mmaisonneuve3/Senior_Design/EEG_cap_final.brd

## EAGLE design EEG_cap_final.brd (2021-11-14)

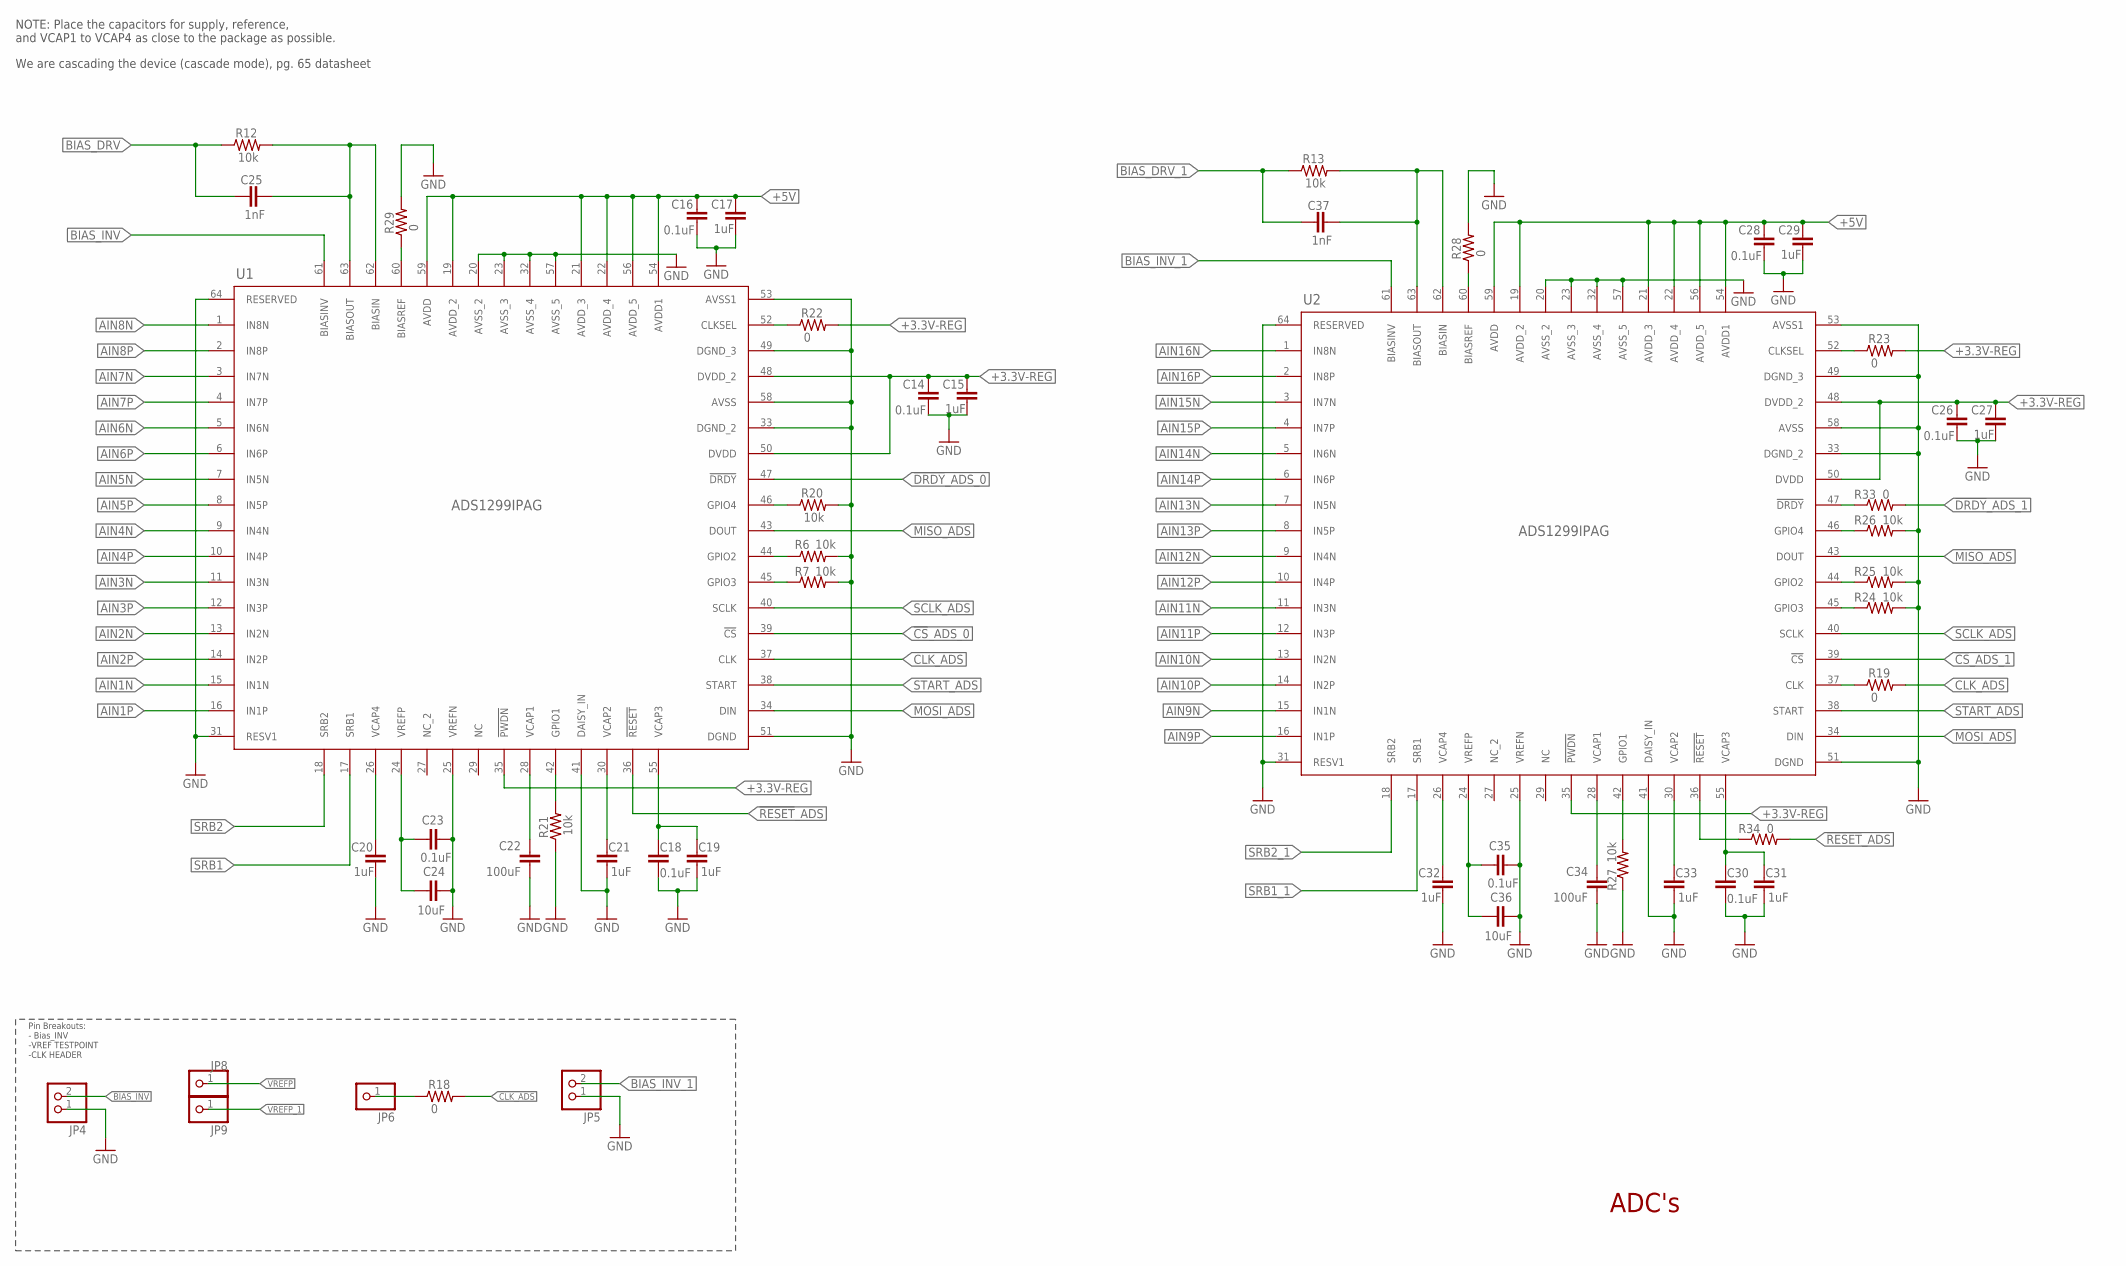
[picture p1: schematic EEG_cap_final.sch, sheet 1]

Parts:
C14, C16, C18, C23, C26, C28, C30, C35: 0.1uF; C0603
C15, C17, C19, C20, C21, C27, C29, C31, C32, C33: 1uF; C0603
C22, C34: 100uF; C1210
C24, C36: 10uF; C0805
C25, C37: 1nF; C0603
JP4, JP5: PINHD-1X2; 1X02
JP6, JP8, JP9: PINHD-1X1; 1X01
R6, R7, R12, R13, R20, R21, R24, R25, R26, R27: 10k; R0805
R18, R19, R22, R23, R28, R29, R33, R34: 0; R0805
U1, U2: ADS1299IPAG; PAG64_TEX

Connections:
!CS!_ADS_0: U1.39 (!CS); also elsewhere on the board
!CS!_ADS_1: U2.39 (!CS); also elsewhere on the board
!DRDY!_1: R33.1, U2.47 (!DRDY)
!DRDY!_ADS_0: U1.47 (!DRDY); also elsewhere on the board
!DRDY!_ADS_1: R33.2; also elsewhere on the board
!RESET!_ADS: R34.2, U1.36 (!RESET); also elsewhere on the board
!RESET!_ADS_1: R34.1, U2.36 (!RESET)
+3.3V-REG: C14.1, C15.1, C26.1, C27.1, R22.2, R23.2, U1.35 (!PWDN), U1.48 (DVDD_2), U1.50 (DVDD), U2.35 (!PWDN), U2.48 (DVDD_2), U2.50 (DVDD); also elsewhere on the board
+5V: C16.1, C17.1, C28.1, C29.1, U1.19 (AVDD_2), U1.21 (AVDD_3), U1.22 (AVDD_4), U1.54 (AVDD1), U1.56 (AVDD_5), U1.59 (AVDD), U2.19 (AVDD_2), U2.21 (AVDD_3), U2.22 (AVDD_4), U2.54 (AVDD1), U2.56 (AVDD_5), U2.59 (AVDD); also elsewhere on the board
AIN1N: U1.15 (IN1N); also elsewhere on the board
AIN1P: U1.16 (IN1P); also elsewhere on the board
AIN2N: U1.13 (IN2N); also elsewhere on the board
AIN2P: U1.14 (IN2P); also elsewhere on the board
AIN3N: U1.11 (IN3N); also elsewhere on the board
AIN3P: U1.12 (IN3P); also elsewhere on the board
AIN4N: U1.9 (IN4N); also elsewhere on the board
AIN4P: U1.10 (IN4P); also elsewhere on the board
AIN5N: U1.7 (IN5N); also elsewhere on the board
AIN5P: U1.8 (IN5P); also elsewhere on the board
AIN6N: U1.5 (IN6N); also elsewhere on the board
AIN6P: U1.6 (IN6P); also elsewhere on the board
AIN7N: U1.3 (IN7N); also elsewhere on the board
AIN7P: U1.4 (IN7P); also elsewhere on the board
AIN8N: U1.1 (IN8N); also elsewhere on the board
AIN8P: U1.2 (IN8P); also elsewhere on the board
AIN9N: U2.15 (IN1N); also elsewhere on the board
AIN9P: U2.16 (IN1P); also elsewhere on the board
AIN10N: U2.13 (IN2N); also elsewhere on the board
AIN10P: U2.14 (IN2P); also elsewhere on the board
AIN11N: U2.11 (IN3N); also elsewhere on the board
AIN11P: U2.12 (IN3P); also elsewhere on the board
AIN12N: U2.9 (IN4N); also elsewhere on the board
AIN12P: U2.10 (IN4P); also elsewhere on the board
AIN13N: U2.7 (IN5N); also elsewhere on the board
AIN13P: U2.8 (IN5P); also elsewhere on the board
AIN14N: U2.5 (IN6N); also elsewhere on the board
AIN14P: U2.6 (IN6P); also elsewhere on the board
AIN15N: U2.3 (IN7N); also elsewhere on the board
AIN15P: U2.4 (IN7P); also elsewhere on the board
AIN16N: U2.1 (IN8N); also elsewhere on the board
AIN16P: U2.2 (IN8P); also elsewhere on the board
BIAS1_IN: C37.2, R13.2, U2.62 (BIASIN), U2.63 (BIASOUT)
BIAS_DRV: C25.1, R12.1; also elsewhere on the board
BIAS_DRV_1: C37.1, R13.1; also elsewhere on the board
BIAS_IN: C25.2, R12.2, U1.62 (BIASIN), U1.63 (BIASOUT)
BIAS_INV: JP4.2, U1.61 (BIASINV)
BIAS_INV_1: JP5.2, U2.61 (BIASINV)
BIAS_REF: R29.1, U1.60 (BIASREF)
BIAS_REF_1: R28.1, U2.60 (BIASREF)
CLK: R19.1, U2.37 (CLK)
CLKSEL_0: R22.1, U1.52 (CLKSEL)
CLKSEL_1: R23.1, U2.52 (CLKSEL)
CLK_ADS: R18.2, R19.2, U1.37 (CLK)
CLK_HDR: JP6.1, R18.1
GND: C14.2, C15.2, C16.2, C17.2, C18.2, C19.2, C20.2, C21.2, C22.2, C23.2, C24.2, C26.2, C27.2, C28.2, C29.2, C30.2, C31.2, C32.2, C33.2, C34.2, C35.2, C36.2, JP4.1, JP5.1, R6.2, R7.2, R20.2, R21.1, R24.2, R25.2, R26.2, R27.1, R28.2, R29.2, U1.20 (AVSS_2), U1.23 (AVSS_3), U1.25 (VREFN), U1.31 (RESV1), U1.32 (AVSS_4), U1.33 (DGND_2), U1.41 (DAISY_IN), U1.49 (DGND_3), U1.51 (DGND), U1.53 (AVSS1), U1.57 (AVSS_5), U1.58 (AVSS), U1.64 (RESERVED), U2.20 (AVSS_2), U2.23 (AVSS_3), U2.25 (VREFN), U2.31 (RESV1), U2.32 (AVSS_4), U2.33 (DGND_2), U2.41 (DAISY_IN), U2.49 (DGND_3), U2.51 (DGND), U2.53 (AVSS1), U2.57 (AVSS_5), U2.58 (AVSS), U2.64 (RESERVED); also elsewhere on the board
MISO_ADS: U1.43 (DOUT), U2.43 (DOUT); also elsewhere on the board
MOSI_ADS: U1.34 (DIN), U2.34 (DIN); also elsewhere on the board
unnamed: R21.2, U1.42 (GPIO1)
unnamed: R7.1, U1.45 (GPIO3)
unnamed: R6.1, U1.44 (GPIO2)
unnamed: R20.1, U1.46 (GPIO4)
unnamed: R24.1, U2.45 (GPIO3)
unnamed: R25.1, U2.44 (GPIO2)
unnamed: R26.1, U2.46 (GPIO4)
unnamed: R27.2, U2.42 (GPIO1)
SCLK_ADS: U1.40 (SCLK), U2.40 (SCLK); also elsewhere on the board
SRB1: U1.17 (SRB1); also elsewhere on the board
SRB1_1: U2.17 (SRB1); also elsewhere on the board
SRB2: U1.18 (SRB2); also elsewhere on the board
SRB2_1: U2.18 (SRB2); also elsewhere on the board
START_ADS: U1.38 (START), U2.38 (START); also elsewhere on the board
VCAP1: C22.1, U1.28 (VCAP1)
VCAP1_1: C34.1, U2.28 (VCAP1)
VCAP2: C21.1, U1.30 (VCAP2)
VCAP2_1: C33.1, U2.30 (VCAP2)
VCAP3: C18.1, C19.1, U1.55 (VCAP3)
VCAP3_1: C30.1, C31.1, U2.55 (VCAP3)
VCAP4: C20.1, U1.26 (VCAP4)
VCAP6: C32.1, U2.26 (VCAP4)
VREFP: C23.1, C24.1, JP8.1, U1.24 (VREFP)
VREFP_1: C35.1, C36.1, JP9.1, U2.24 (VREFP)

Notes on the sheet:
ADC's
NOTE: Place the capacitors for supply, reference, and VCAP1 to VCAP4 as close to the package as possible.
We are cascading the device (cascade mode), pg. 65 datasheet
Pin Breakouts: - Bias_INV -VREF TESTPOINT -CLK HEADER

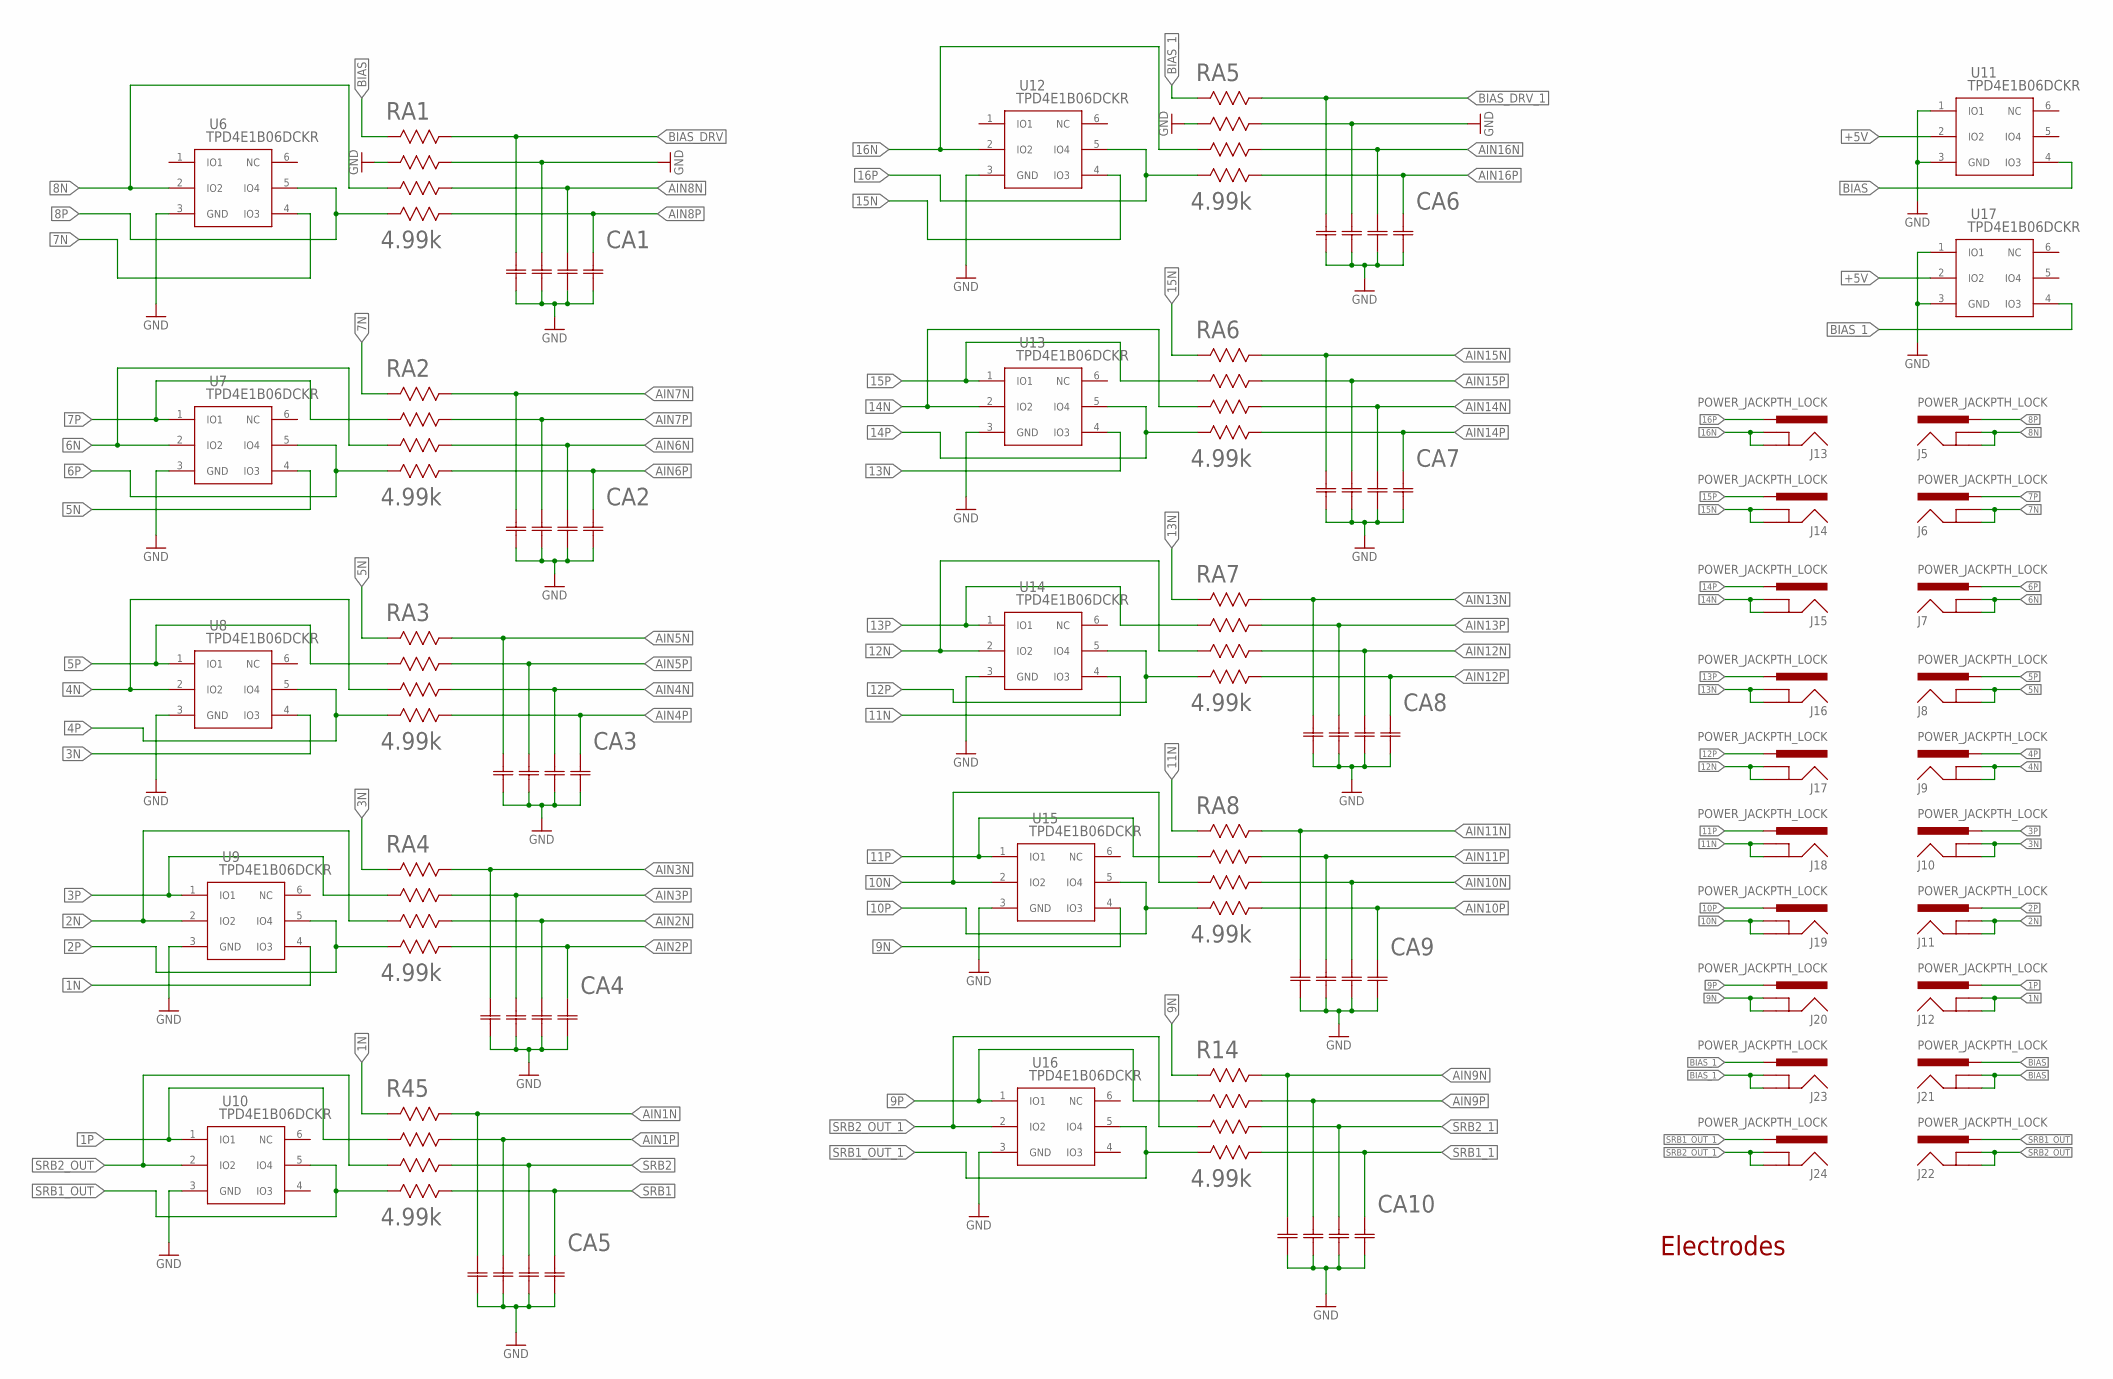
[picture p2: schematic EEG_cap_final.sch, sheet 2]

Parts:
CA1, CA2, CA3, CA4, CA5, CA6, CA7, CA8, CA9, CA10: 4.7nF; CAP_CA0612_3P2X1P6_YAG
J5, J6, J7, J8, J9, J10, J11, J12, J13, J14, J15, J16, J17, J18, J19, J20, J21, J22, J23, J24: POWER_JACKPTH_LOCK; POWER_JACK_PTH_LOCK
R14, R45: 4.99k; BO_CAT16
RA1, RA2, RA3, RA4, RA5, RA6, RA7, RA8: 4.99k; BO_CAT16
U6, U7, U8, U9, U10, U11, U12, U13, U14, U15, U16, U17: TPD4E1B06DCKR; DCK6_TEX

Connections:
1N: J12.GND, J12.GNDBREAK, R45.1, U9.4 (IO3)
1P: J12.PWR, R45.2, U10.1 (IO1)
2N: J11.GND, J11.GNDBREAK, RA4.3, U9.2 (IO2)
2P: J11.PWR, RA4.4, U9.5 (IO4)
3N: J10.GND, J10.GNDBREAK, RA4.1, U8.4 (IO3)
3P: J10.PWR, RA4.2, U9.1 (IO1)
4N: J9.GND, J9.GNDBREAK, RA3.3, U8.2 (IO2)
4P: J9.PWR, RA3.4, U8.5 (IO4)
5N: J8.GND, J8.GNDBREAK, RA3.1, U7.4 (IO3)
5P: J8.PWR, RA3.2, U8.1 (IO1)
6N: J7.GND, J7.GNDBREAK, RA2.3, U7.2 (IO2)
6P: J7.PWR, RA2.4, U7.5 (IO4)
7N: J6.GND, J6.GNDBREAK, RA2.1, U6.4 (IO3)
7P: J6.PWR, RA2.2, U7.1 (IO1)
8N: J5.GND, J5.GNDBREAK, RA1.3, U6.2 (IO2)
8P: J5.PWR, RA1.4, U6.5 (IO4)
9N: J20.GND, J20.GNDBREAK, R14.1, U15.4 (IO3)
9P: J20.PWR, R14.2, U16.1 (IO1)
10N: J19.GND, J19.GNDBREAK, RA8.3, U15.2 (IO2)
10P: J19.PWR, RA8.4, U15.5 (IO4)
11N: J18.GND, J18.GNDBREAK, RA8.1, U14.4 (IO3)
11P: J18.PWR, RA8.2, U15.1 (IO1)
12N: J17.GND, J17.GNDBREAK, RA7.3, U14.2 (IO2)
12P: J17.PWR, RA7.4, U14.5 (IO4)
13N: J16.GND, J16.GNDBREAK, RA7.1, U13.4 (IO3)
13P: J16.PWR, RA7.2, U14.1 (IO1)
14N: J15.GND, J15.GNDBREAK, RA6.3, U13.2 (IO2)
14P: J15.PWR, RA6.4, U13.5 (IO4)
15N: J14.GND, J14.GNDBREAK, RA6.1, U12.4 (IO3)
15P: J14.PWR, RA6.2, U13.1 (IO1)
16N: J13.GND, J13.GNDBREAK, RA5.3, U12.2 (IO2)
16P: J13.PWR, RA5.4, U12.5 (IO4)
+5V: U11.2 (IO2), U17.2 (IO2); also elsewhere on the board
AIN1N: CA5.8, R45.8; also elsewhere on the board
AIN1P: CA5.7, R45.7; also elsewhere on the board
AIN2N: CA4.6, RA4.6; also elsewhere on the board
AIN2P: CA4.5, RA4.5; also elsewhere on the board
AIN3N: CA4.8, RA4.8; also elsewhere on the board
AIN3P: CA4.7, RA4.7; also elsewhere on the board
AIN4N: CA3.6, RA3.6; also elsewhere on the board
AIN4P: CA3.5, RA3.5; also elsewhere on the board
AIN5N: CA3.8, RA3.8; also elsewhere on the board
AIN5P: CA3.7, RA3.7; also elsewhere on the board
AIN6N: CA2.6, RA2.6; also elsewhere on the board
AIN6P: CA2.5, RA2.5; also elsewhere on the board
AIN7N: CA2.8, RA2.8; also elsewhere on the board
AIN7P: CA2.7, RA2.7; also elsewhere on the board
AIN8N: CA1.6, RA1.6; also elsewhere on the board
AIN8P: CA1.5, RA1.5; also elsewhere on the board
AIN9N: CA10.8, R14.8; also elsewhere on the board
AIN9P: CA10.7, R14.7; also elsewhere on the board
AIN10N: CA9.6, RA8.6; also elsewhere on the board
AIN10P: CA9.5, RA8.5; also elsewhere on the board
AIN11N: CA9.8, RA8.8; also elsewhere on the board
AIN11P: CA9.7, RA8.7; also elsewhere on the board
AIN12N: CA8.6, RA7.6; also elsewhere on the board
AIN12P: CA8.5, RA7.5; also elsewhere on the board
AIN13N: CA8.8, RA7.8; also elsewhere on the board
AIN13P: CA8.7, RA7.7; also elsewhere on the board
AIN14N: CA7.6, RA6.6; also elsewhere on the board
AIN14P: CA7.5, RA6.5; also elsewhere on the board
AIN15N: CA7.8, RA6.8; also elsewhere on the board
AIN15P: CA7.7, RA6.7; also elsewhere on the board
AIN16N: CA6.6, RA5.6; also elsewhere on the board
AIN16P: CA6.5, RA5.5; also elsewhere on the board
BIAS: J21.GND, J21.GNDBREAK, J21.PWR, RA1.1, U11.4 (IO3)
BIAS_1: J23.GND, J23.GNDBREAK, J23.PWR, RA5.1, U17.4 (IO3)
BIAS_DRV: CA1.8, RA1.8; also elsewhere on the board
BIAS_DRV_1: CA6.8, RA5.8; also elsewhere on the board
GND: CA1.1, CA1.2, CA1.3, CA1.4, CA1.7, CA2.1, CA2.2, CA2.3, CA2.4, CA3.1, CA3.2, CA3.3, CA3.4, CA4.1, CA4.2, CA4.3, CA4.4, CA5.1, CA5.2, CA5.3, CA5.4, CA6.1, CA6.2, CA6.3, CA6.4, CA6.7, CA7.1, CA7.2, CA7.3, CA7.4, CA8.1, CA8.2, CA8.3, CA8.4, CA9.1, CA9.2, CA9.3, CA9.4, CA10.1, CA10.2, CA10.3, CA10.4, RA1.2, RA1.7, RA5.2, RA5.7, U6.3 (GND), U7.3 (GND), U8.3 (GND), U9.3 (GND), U10.3 (GND), U11.1 (IO1), U11.3 (GND), U12.3 (GND), U13.3 (GND), U14.3 (GND), U15.3 (GND), U16.3 (GND), U17.1 (IO1), U17.3 (GND); also elsewhere on the board
SRB1: CA5.5, R45.5; also elsewhere on the board
SRB1_1: CA10.5, R14.5; also elsewhere on the board
SRB1_OUT: J22.PWR, R45.4, U10.5 (IO4)
SRB1_OUT_1: J24.PWR, R14.4, U16.5 (IO4)
SRB2: CA5.6, R45.6; also elsewhere on the board
SRB2_1: CA10.6, R14.6; also elsewhere on the board
SRB2_OUT: J22.GND, J22.GNDBREAK, R45.3, U10.2 (IO2)
SRB2_OUT_1: J24.GND, J24.GNDBREAK, R14.3, U16.2 (IO2)

Notes on the sheet:
Electrodes

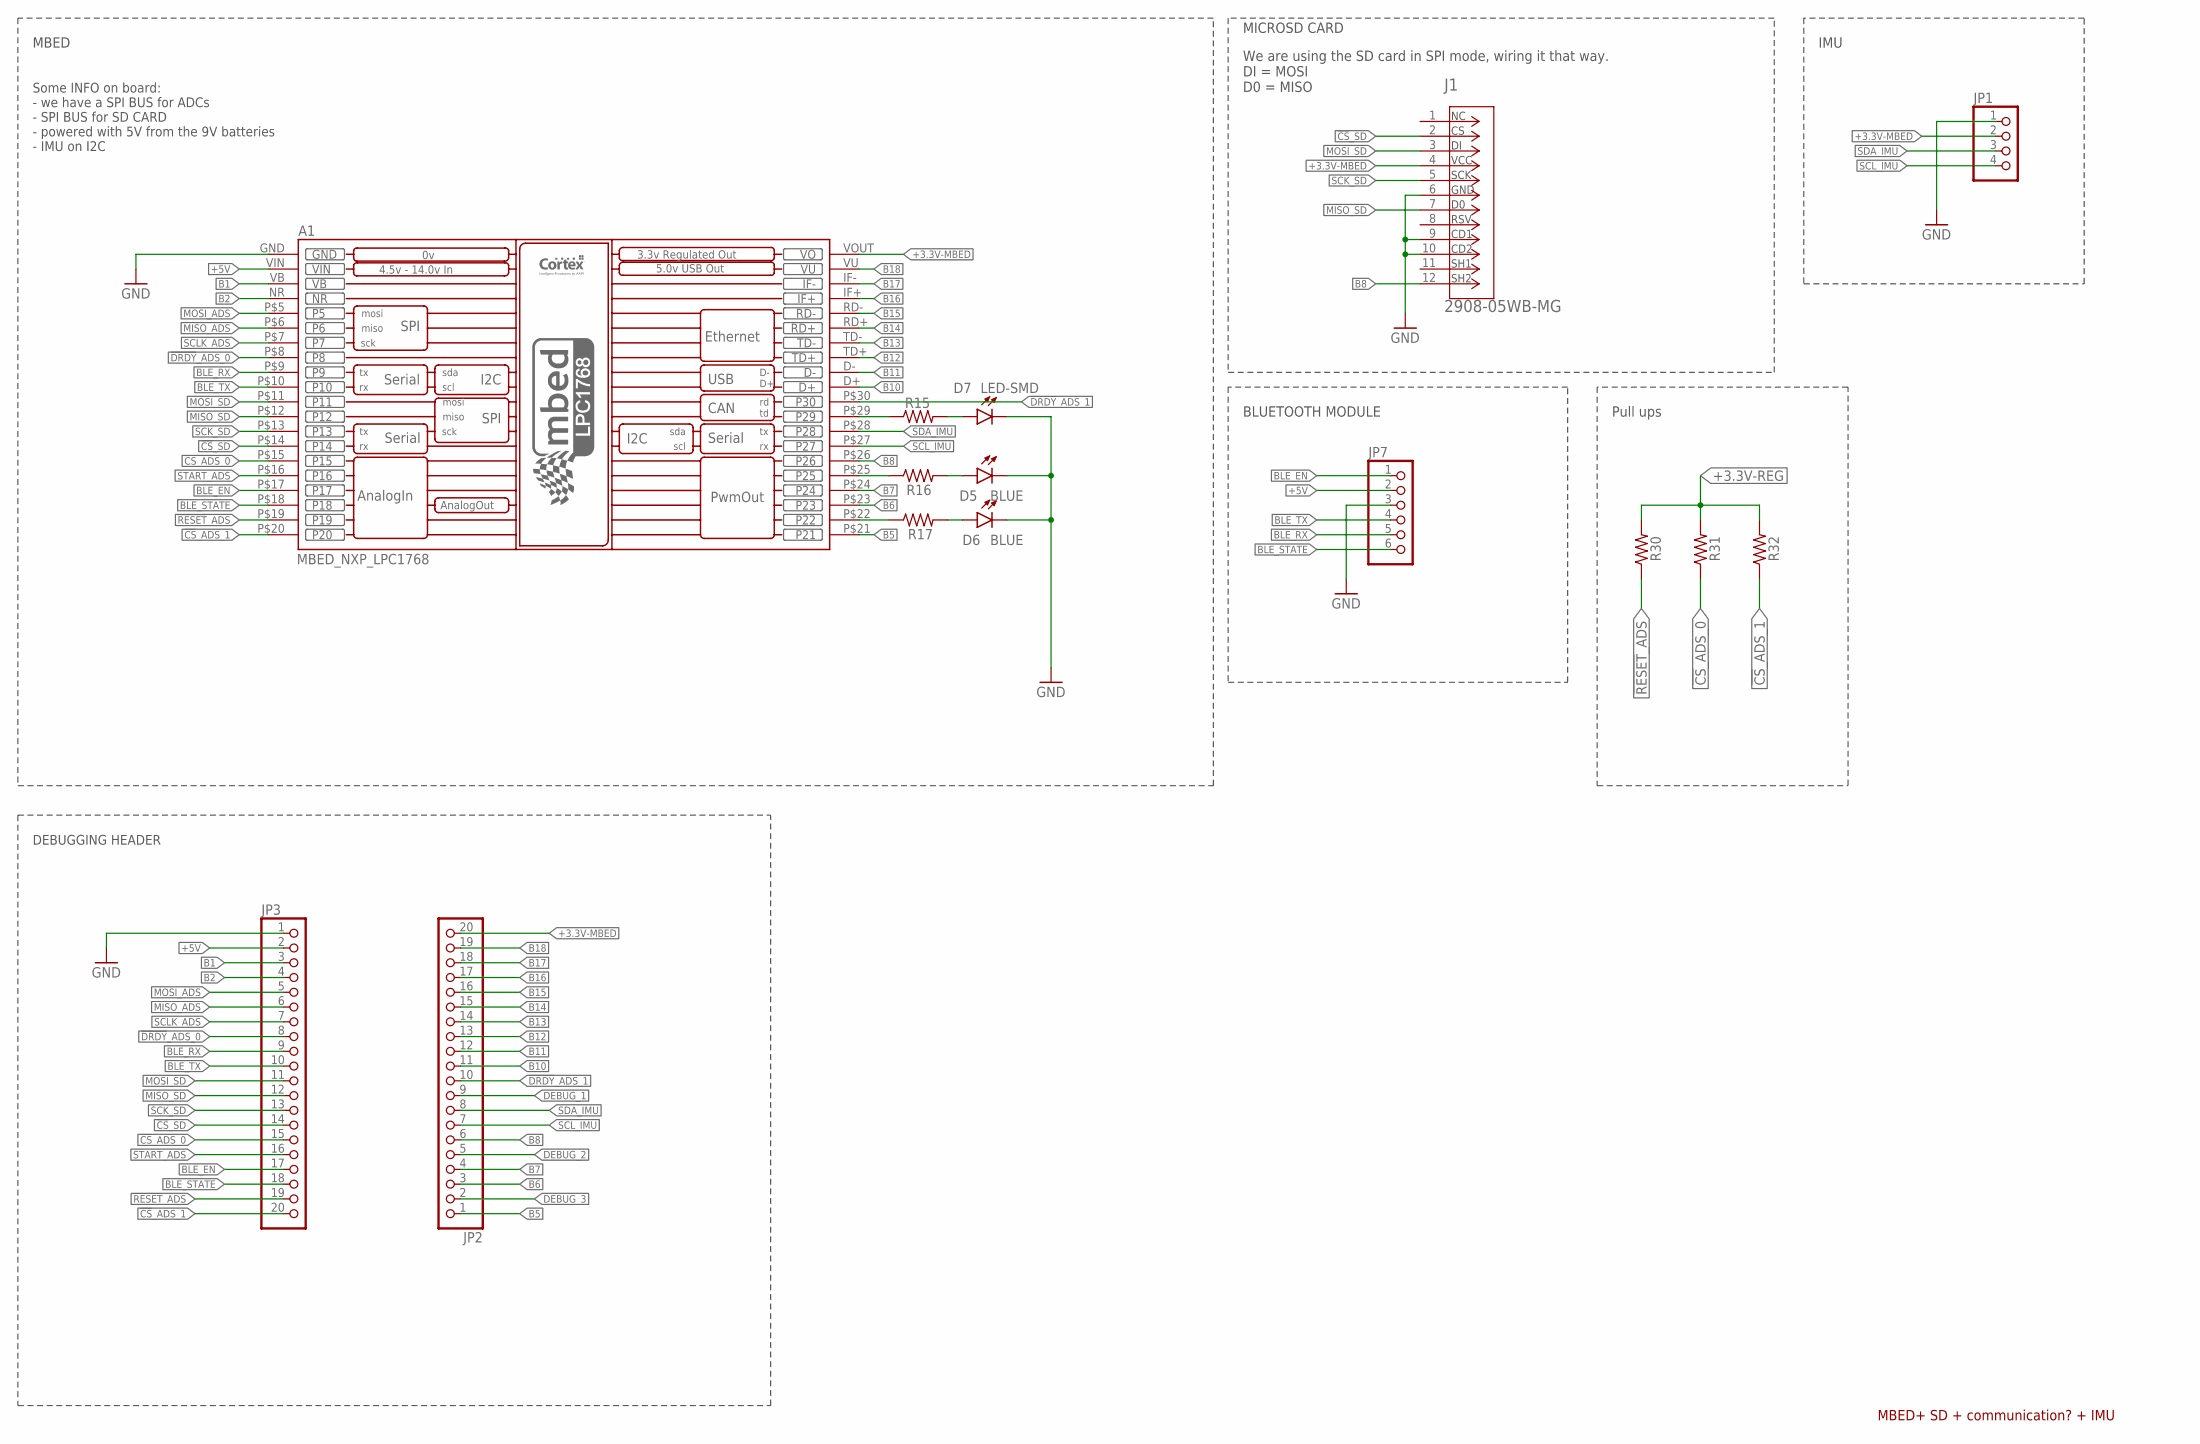
[picture p3: schematic EEG_cap_final.sch, sheet 3]

Parts:
A1: MBED_NXP_LPC1768; MBED_LPC1768
D5, D6: BLUE; LED0603
D7: LED-SMD; LED0603
J1: 2908-05WB-MG; CONN_3M_2900
JP1: PINHD-1X4; 1X04
JP2, JP3: PINHD-1X20; 1X20
JP7: PINHD-1X6; 1X06
R15, R16, R17, R31, R32: 1k; R0805
R30: 10k; R0805

Connections:
!CS!_ADS_0: A1.P$15 (P15), JP3.15, R31.1; also elsewhere on the board
!CS!_ADS_1: A1.P$20 (P20), JP3.20, R32.1; also elsewhere on the board
!CS!_SD: A1.P$14 (P14), J1.2, JP3.14
!DRDY!_ADS_0: A1.P$8 (P8), JP3.8; also elsewhere on the board
!DRDY!_ADS_1: A1.P$30 (P30), JP2.10; also elsewhere on the board
!RESET!_ADS: A1.P$19 (P19), JP3.19, R30.1; also elsewhere on the board
+3.3V-MBED: A1.VOUT (VO), J1.4, JP1.2, JP2.20; also elsewhere on the board
+3.3V-REG: R30.2, R31.2, R32.2; also elsewhere on the board
+5V: A1.VIN, JP3.2, JP7.2; also elsewhere on the board
B1: A1.VB, JP3.3
B2: A1.NR, JP3.4
B5: A1.P$21 (P21), JP2.1
B6: A1.P$23 (P23), JP2.3
B7: A1.P$24 (P24), JP2.4
B8: A1.P$26 (P26), J1.12, JP2.6
B10: A1.D+, JP2.11
B11: A1.D-, JP2.12
B12: A1.TD+, JP2.13
B13: A1.TD-, JP2.14
B14: A1.RD+, JP2.15
B15: A1.RD-, JP2.16
B16: A1.IF+, JP2.17
B17: A1.IF-, JP2.18
B18: A1.VU, JP2.19
BLE_EN: A1.P$17 (P17), JP3.17, JP7.1
BLE_RX: A1.P$9 (P9), JP3.9, JP7.5
BLE_STATE: A1.P$18 (P18), JP3.18, JP7.6
BLE_TX: A1.P$10 (P10), JP3.10, JP7.4
DEBUG_1: A1.P$29 (P29), JP2.9, R15.1
DEBUG_2: A1.P$25 (P25), JP2.5, R16.1
DEBUG_3: A1.P$22 (P22), JP2.2, R17.1
GND: A1.GND, D5.C, D6.C, D7.C, J1.6, J1.9, J1.10, JP1.1, JP3.1, JP7.3; also elsewhere on the board
LED-1: D7.A, R15.2
LED_2: D5.A, R16.2
LED_3: D6.A, R17.2
MISO_ADS: A1.P$6 (P6), JP3.6; also elsewhere on the board
MISO_SD: A1.P$12 (P12), J1.7, JP3.12
MOSI_ADS: A1.P$5 (P5), JP3.5; also elsewhere on the board
MOSI_SD: A1.P$11 (P11), J1.3, JP3.11
SCK_SD: A1.P$13 (P13), J1.5, JP3.13
SCLK_ADS: A1.P$7 (P7), JP3.7; also elsewhere on the board
SCL_IMU: A1.P$27 (P27), JP1.4, JP2.7
SDA_IMU: A1.P$28 (P28), JP1.3, JP2.8
START_ADS: A1.P$16 (P16), JP3.16; also elsewhere on the board

Notes on the sheet:
MBED+ SD + communication? + IMU
MBED
MICROSD CARD
We are using the SD card in SPI mode, wiring it that way. DI = MOSI D0 = MISO
Some INFO on board: - we have a SPI BUS for ADCs - SPI BUS for SD CARD - powered with 5V from the 9V batteries - IMU on I2C
IMU
DEBUGGING HEADER
BLUETOOTH MODULE
Pull ups

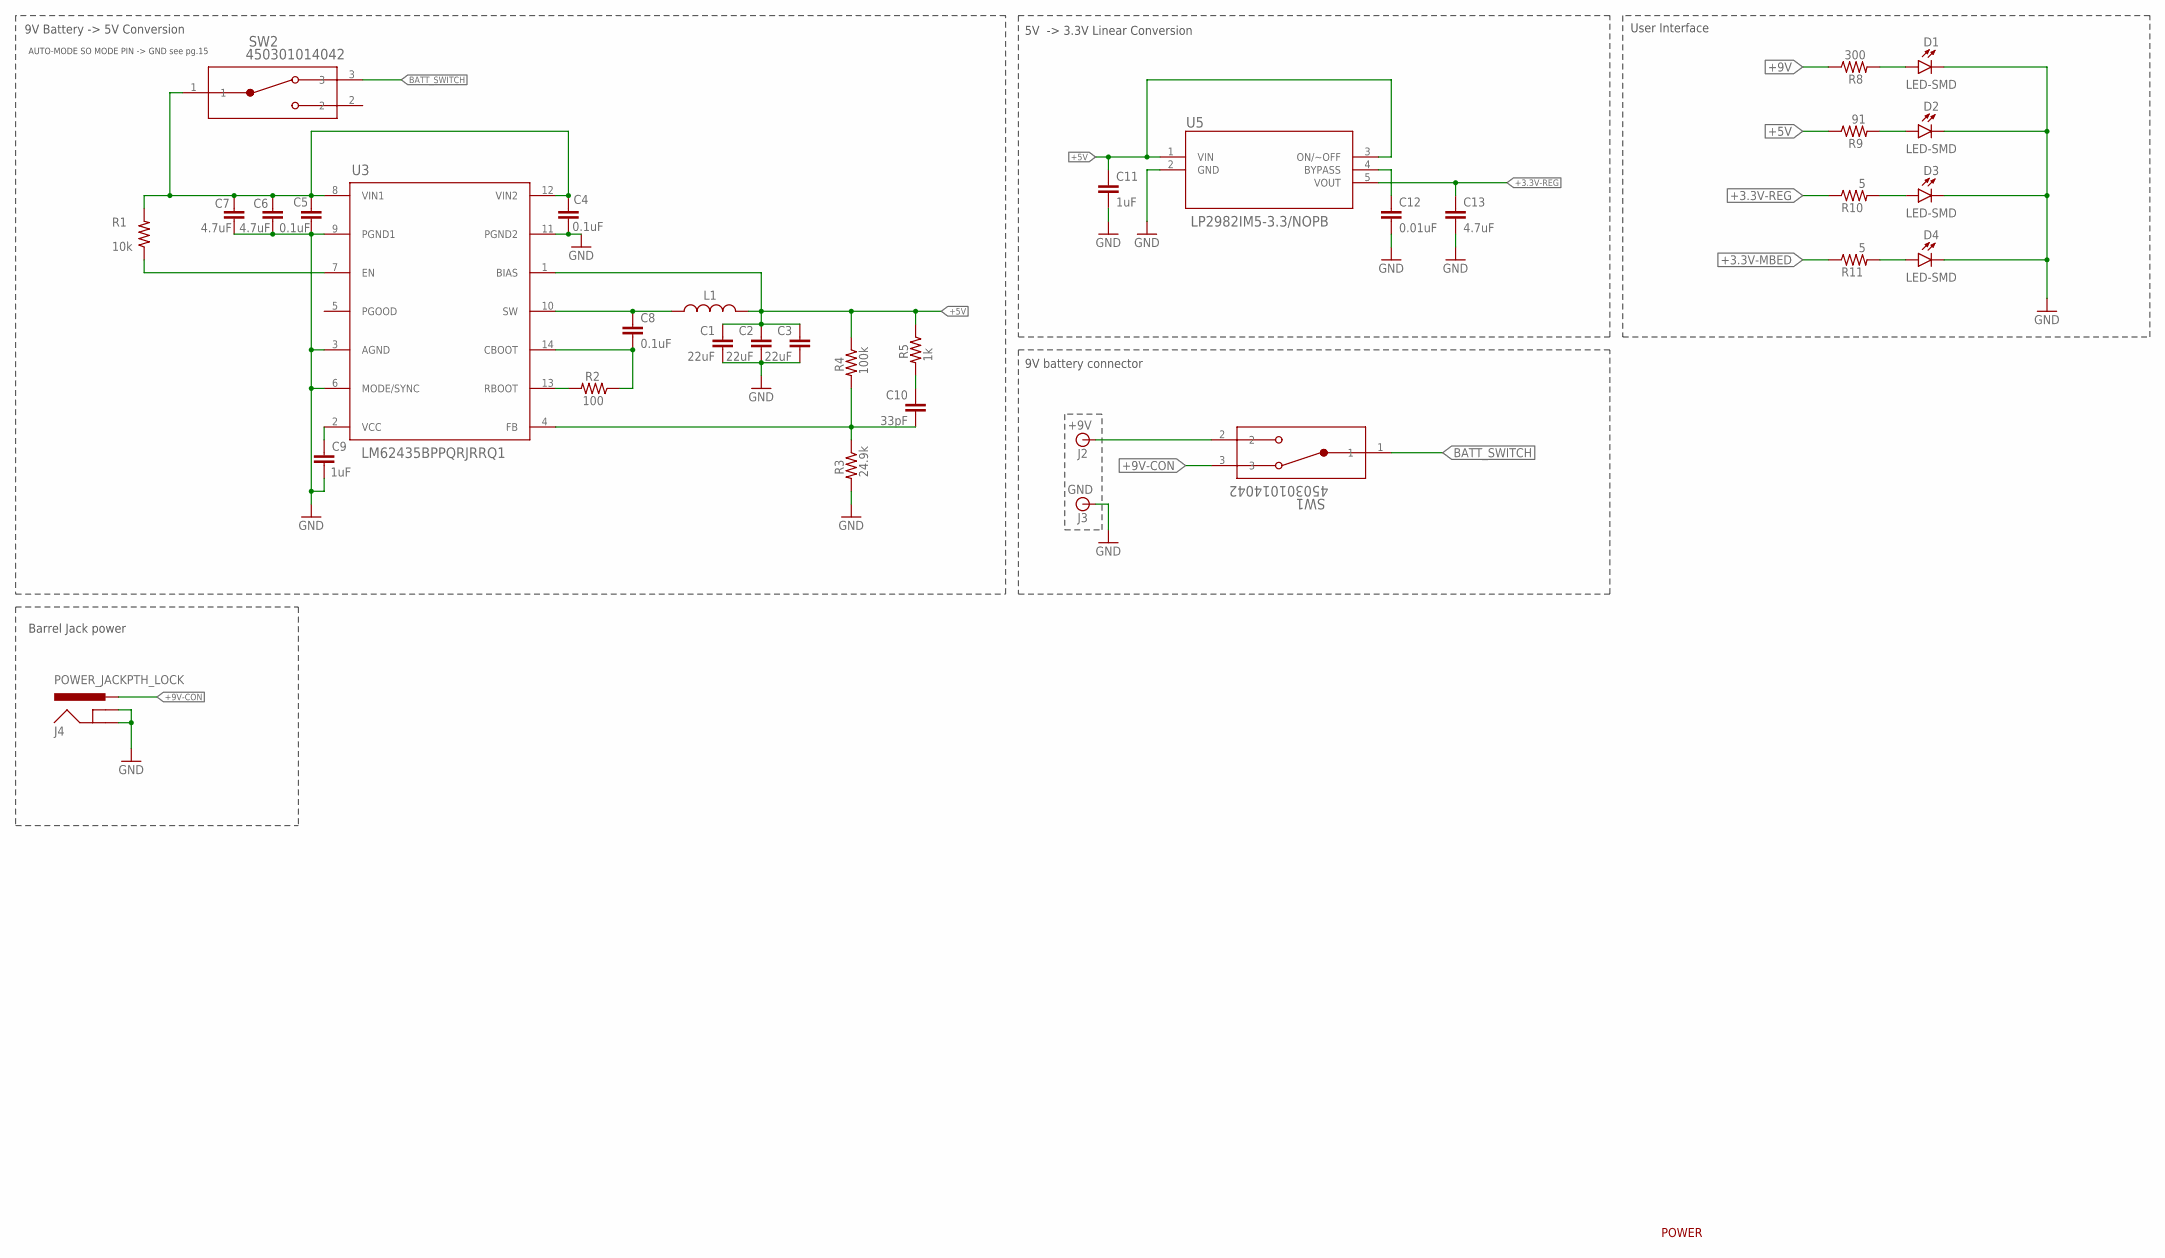
[picture p4: schematic EEG_cap_final.sch, sheet 4]

Parts:
C1, C2, C3: 22uF; C0805
C4, C5, C8: 0.1uF; C0805
C6, C7, C13: 4.7uF; C0805
C9, C11: 1uF; C0805
C10: 33pF; C0805
C12: 0.01uF; C0805
D1, D2, D3, D4: LED-SMD; LED0603
J2: +9V; BANANA_CONN
J3: GND; BANANA_CONN
J4: POWER_JACKPTH_LOCK; POWER_JACK_PTH_LOCK
L1: DFE252010P-1R5M=P2; INDC2520X100N
R1: 10k; R0805
R2: 100; R0805
R3: 24.9k; R0805
R4: 100k; R0805
R5: 1k; R0805
R8: 300; R0805
R9: 91; R0805
R10, R11: 5; R0805
SW1, SW2: 450301014042; SW_450301014042_WRE
U3: LM62435BPPQRJRRQ1; VQFN-HR14_RJR_TEX
U5: LP2982IM5-3.3/NOPB; MF05A

Connections:
3.3V_DIG_LED: D4.A, R11.2
3.3_ANA_LED: D3.A, R10.2
5V_LED: D2.A, R9.2
9V_LED: D1.A, R8.2
+3.3V-MBED: R11.1; also elsewhere on the board
+3.3V-REG: C13.1, R10.1, U5.5 (VOUT); also elsewhere on the board
+5V: C1.1, C2.1, C3.1, C11.1, L1.2, R4.1, R5.1, R9.1, U3.1 (BIAS), U5.1 (VIN), U5.3 (ON/~OFF); also elsewhere on the board
+9V: C4.1, C5.1, C6.1, C7.1, R1.2, R8.1, SW2.1, U3.8 (VIN1), U3.12 (VIN2)
+9V-CON: J4.PWR, SW1.3
+9V_BATT: J2.P$1, SW1.2
BATT_SWITCH: SW1.1, SW2.3
BYPASS: C12.1, U5.4 (BYPASS)
CBOOT: C8.2, R2.1, U3.14 (CBOOT)
EN: R1.1, U3.7 (EN)
FB: C10.2, R3.1, R4.2, U3.4 (FB)
FB_CAP: C10.1, R5.2
GND: C1.2, C2.2, C3.2, C4.2, C5.2, C6.2, C7.2, C9.2, C11.2, C12.2, C13.2, D1.C, D2.C, D3.C, D4.C, J3.P$1, J4.GND, J4.GNDBREAK, R3.2, U3.3 (AGND), U3.6 (MODE/SYNC), U3.9 (PGND1), U3.11 (PGND2), U5.2 (GND); also elsewhere on the board
RBOOT: R2.2, U3.13 (RBOOT)
SW: C8.1, L1.1, U3.10 (SW)
VCC_CHIP: C9.1, U3.2 (VCC)

Notes on the sheet:
POWER
9V Battery -> 5V Conversion
AUTO-MODE SO MODE PIN -> GND see pg.15
5V -> 3.3V Linear Conversion
9V battery connector
User Interface
Barrel Jack power

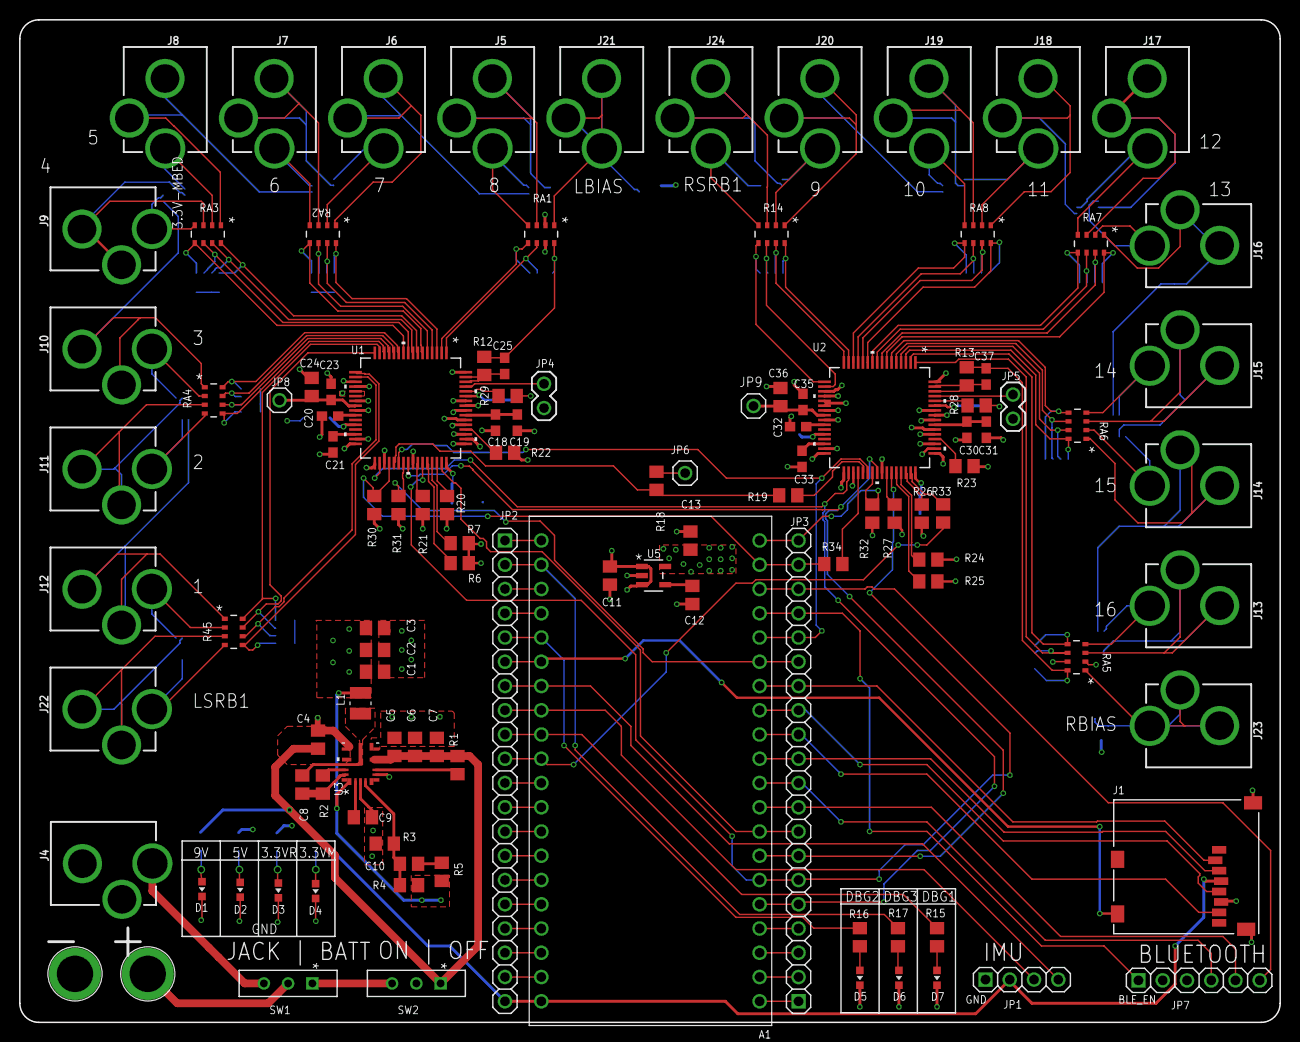
[picture p5: board EEG_cap_final.brd from above]

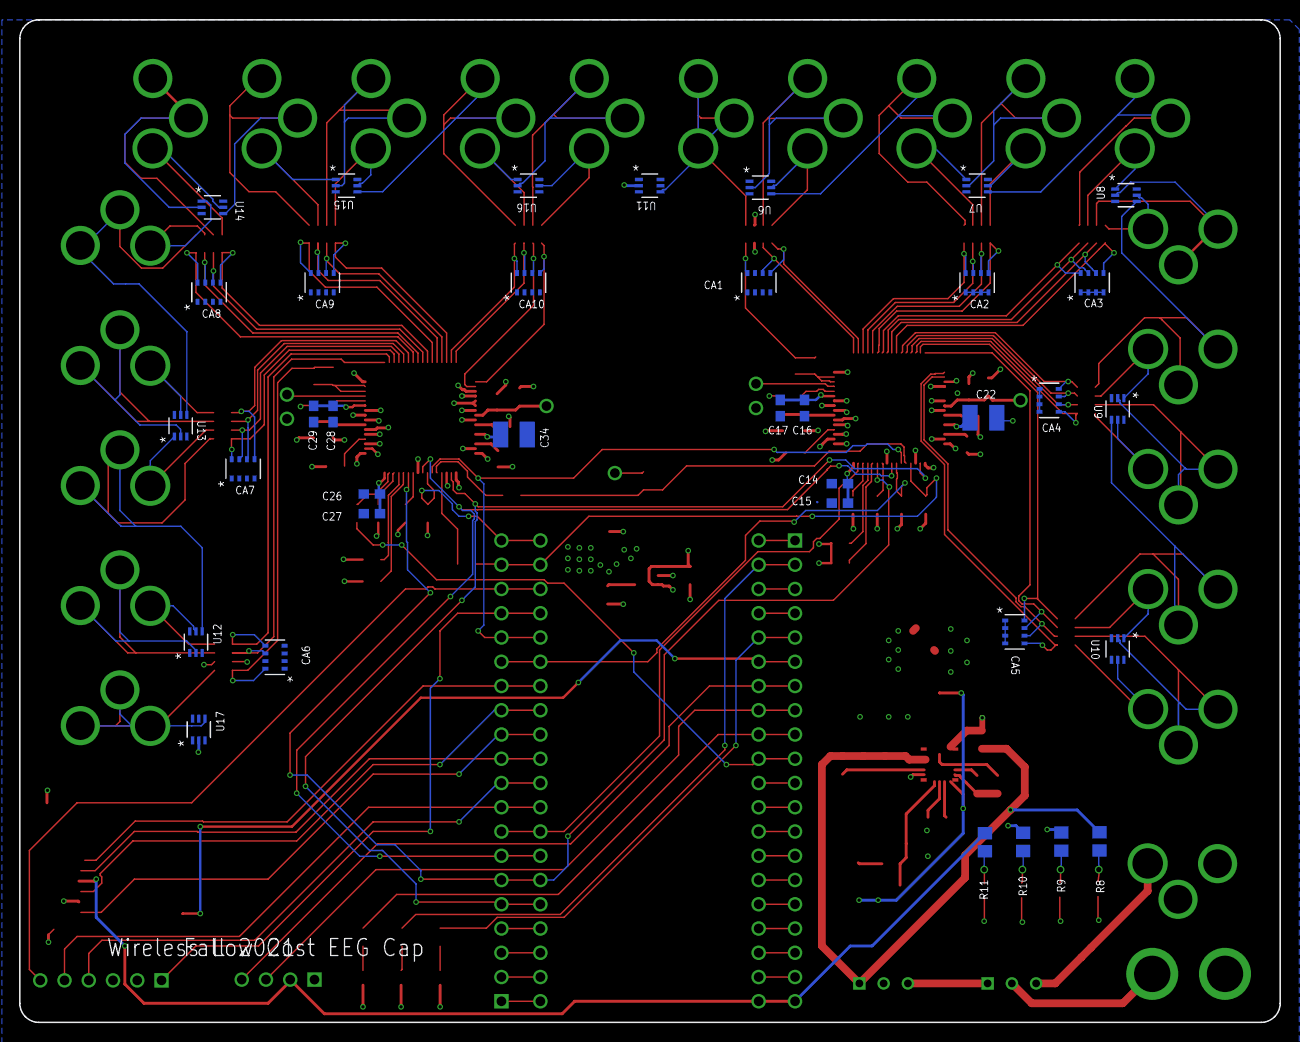
[picture p6: board EEG_cap_final.brd from below]

Board: 4 copper layers, 132.0 x 105.0 mm, 150 parts (36 on the bottom side), 167 nets.
