mmaisonneuve3/Senior_Design/(notices)

Notices in the files:
parts and their libraries:
SparkFun-Connectors: Licensing: Creative Commons ShareAlike 4.0 International - https://creativecommons.org/licenses/by-sa/4.0
COPYRIGHT: Copyright (C) 2021 Ultra Librarian. All rights reserved.
